ToinADMIX/ADMIXData/2023-2024/Posters/ADMIX_Poster_JapanOpen_2024.pdf

## 機体説明

## 回路図

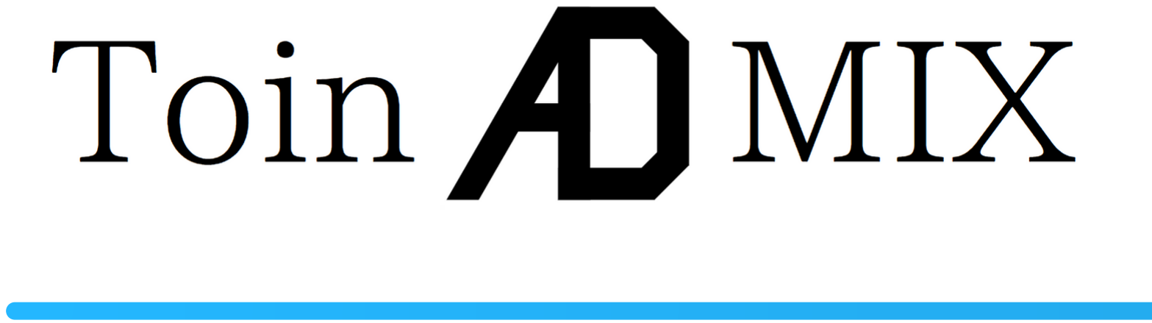
[picture p1: figure]
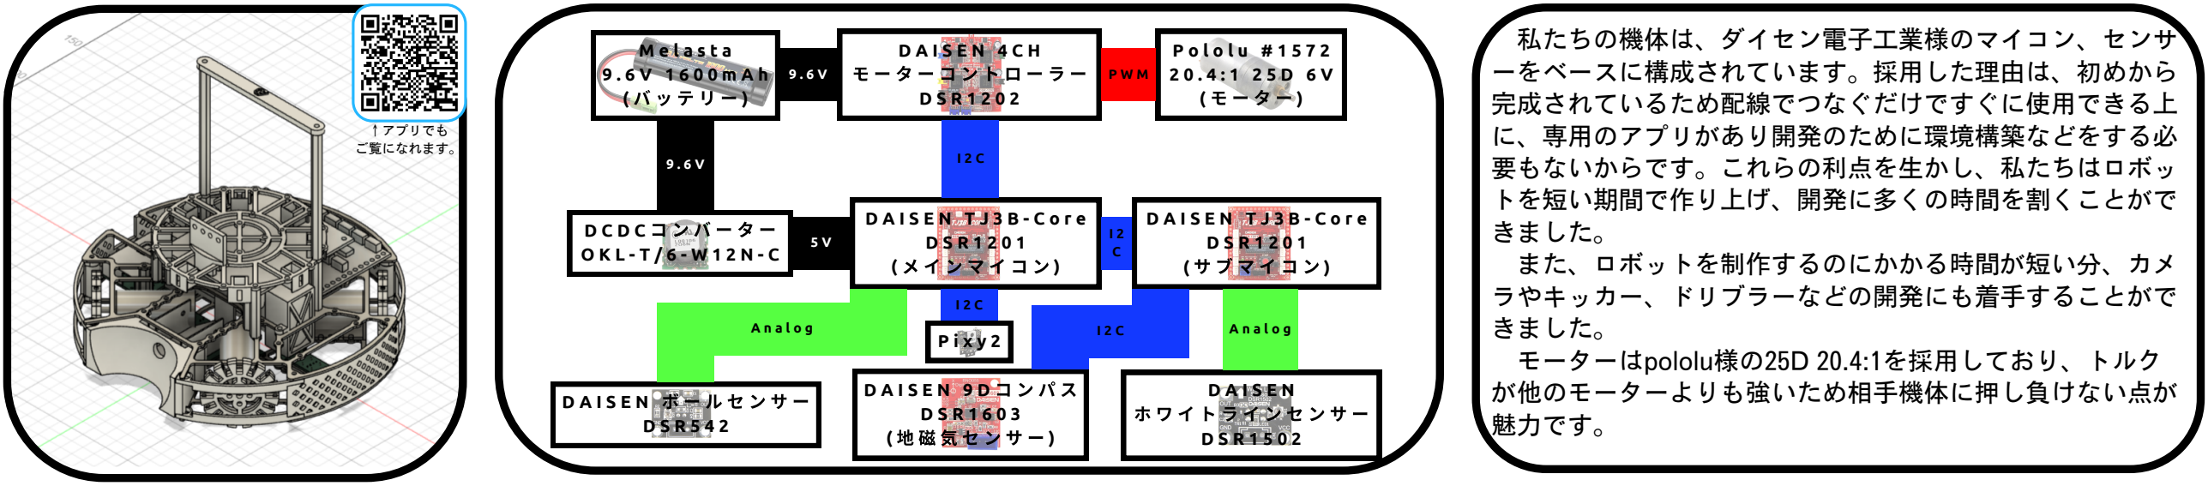
[picture p2: figure]
私たちの機体は、ダイセン電子工業様のマイコン、センサ ーをベースに構成されています。採用した理由は、初めから 完成されているため配線でつなぐだけですぐに使用できる上 に、専用のアプリがあり開発のために環境構築などをする必 要もないからです。これらの利点を生かし、私たちはロボッ トを短い期間で作り上げ、開発に多くの時間を割くことがで きました。 また、ロボットを制作するのにかかる時間が短い分、カメ ラやキッカー、ドリブラーなどの開発にも着手することがで きました。 モーターはpololu様の25D 20.4:1を採用しており、トルク が他のモーターよりも強いため相手機体に押し負けない点が 魅力です。; ↑アプリでも ご覧になれます。

## Pixyカメラを用いたシュート

## 合理的なライン処理

HomePage | Blog | X

### Asahi Ueno Haruku Akema Hiromiti Matsui

和歌山県立桐蔭高等学校科学部
和歌山ノード3位
関西ブロック3位
安定した防御 | アプリの活用

## 3Dモデル

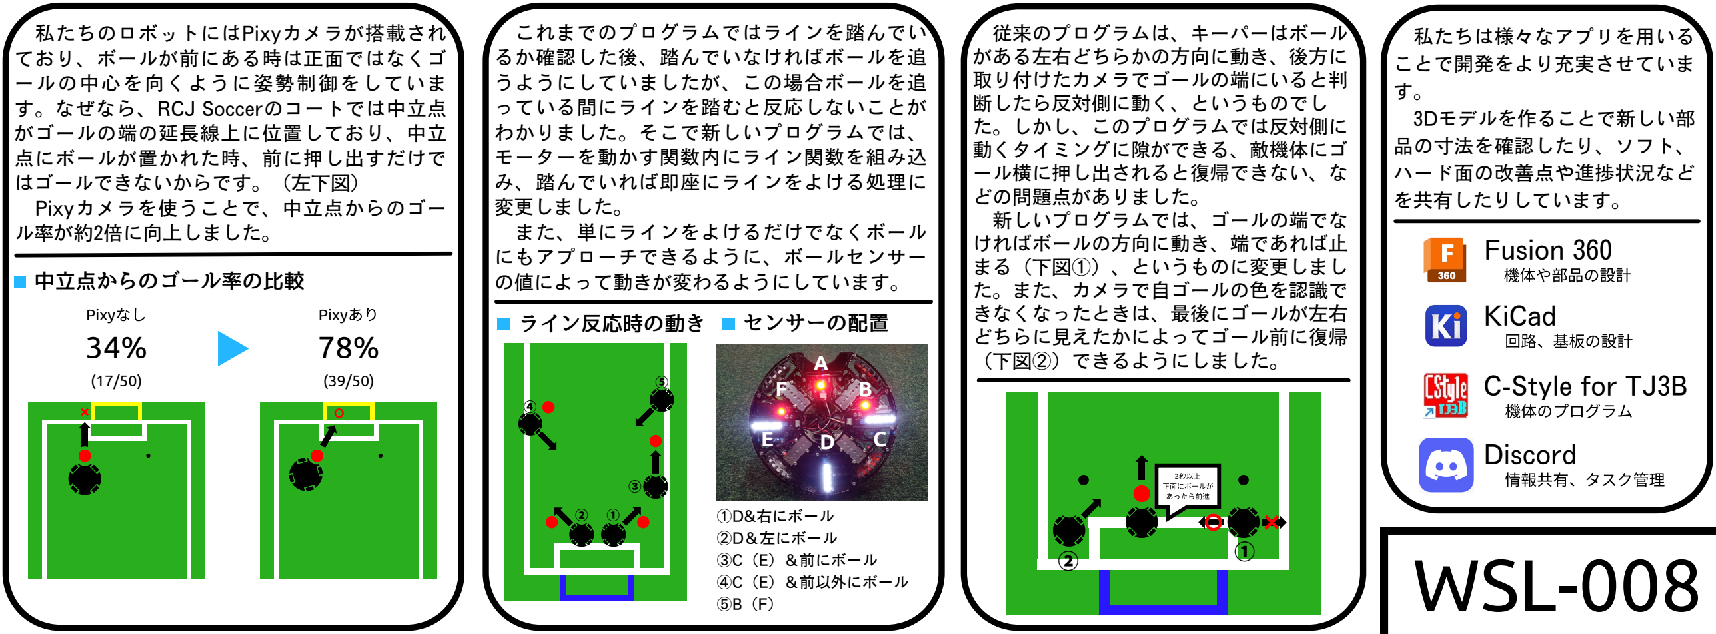
[picture p3: figure]
中立点からのゴール率の比較; Pixyなし; Pixyあり; 私たちのロボットにはPixyカメラが搭載され ており、ボールが前にある時は正面ではなくゴ ールの中心を向くように姿勢制御をしていま す。なぜなら、RCJ Soccerのコートでは中立点 がゴールの端の延長線上に位置しており、中立 点にボールが置かれた時、前に押し出すだけで はゴールできないからです。（左下図） Pixyカメラを使うことで、中立点からのゴー ル率が約2倍に向上しました。; ライン反応時の動き; センサーの配置; ①D&右にボール ②D＆左にボール ③C（E）＆前にボール ④C（E）＆前以外にボール ⑤B（F）; これまでのプログラムではラインを踏んでい るか確認した後、踏んでいなければボールを追 うようにしていましたが、この場合ボールを追 っている間にラインを踏むと反応しないことが わかりました。そこで新しいプログラムでは、 モーターを動かす関数内にライン関数を組み込 み、踏んでいれば即座にラインをよける処理に 変更しました。 また、単にラインをよけるだけでなくボール にもアプローチできるように、ボールセンサー の値によって動きが変わるようにしています。; WSL-008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
