ToinADMIX/ADMIXData/2024-2025/Hard/3DModels/admix_1_dribbler_ver5.step

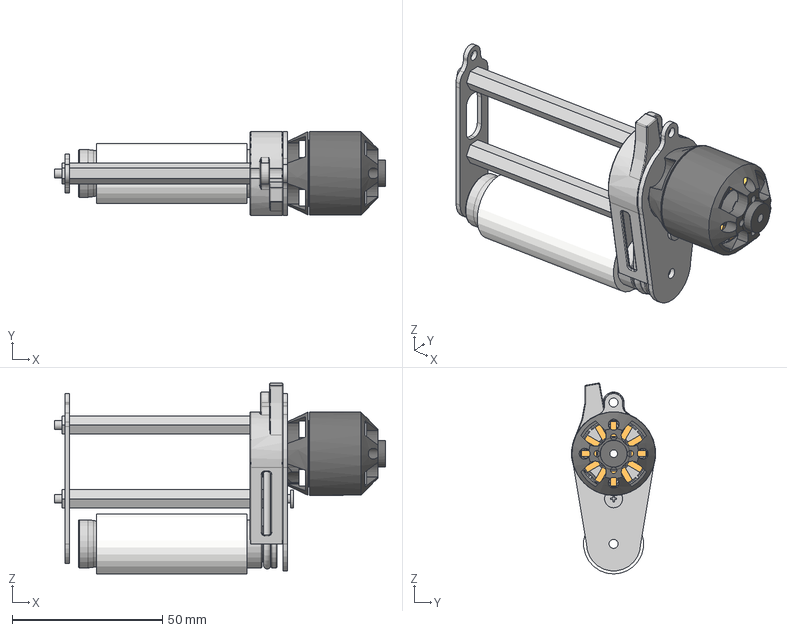
[picture p4: CAD file, 2025-06-26]
2024-2025/Hard/3DModels/admix_1_dribbler_ver5.step
110.1 x 27.9 x 63.5 mm
coil
dribbler5_alumiR
dribbler4_pillar
dribbler3_tube
dribbler5_rubberwheel
dribbler5_wheel_motor
spacer_10mm
spacer_60mm x 2
nut x 2
flatscrew x 2
dribbler5_alumiL_ver2
dribbler5_cover_ver2
