ToinADMIX/ADMIXData/2024-2025/Posters/ADMIX_Poster_JapanOpen_2025.pdf

## 回路図

## 上野朝陽 - 設計

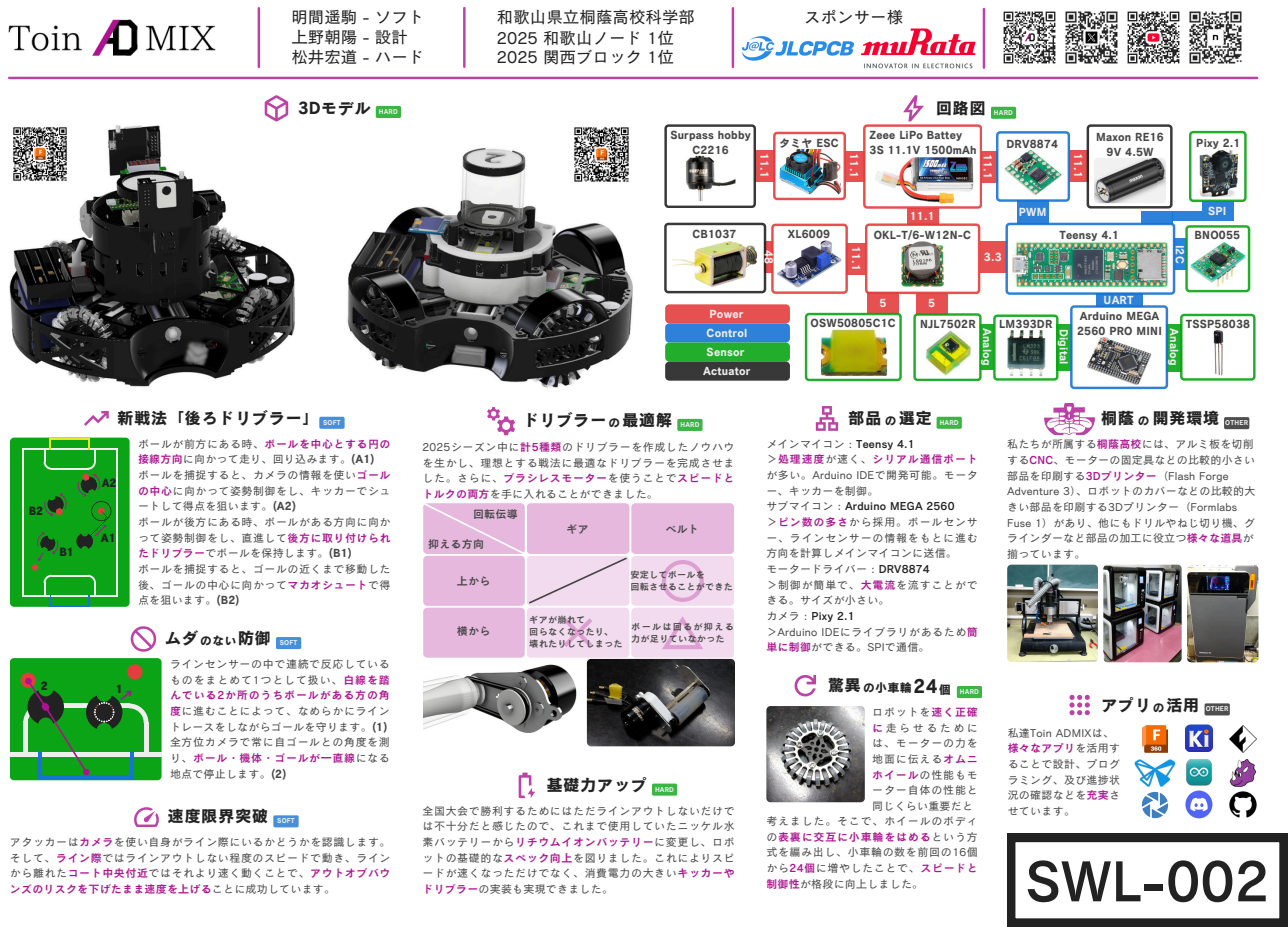
[picture p5: page 1]
SWL-002; 新戦法「後ろドリブラー」; ボールが前方にある時、ボールを中心とする円の 接線方向に向かって走り、回り込みます。(A1) ボールを捕捉すると、カメラの情報を使いゴール の中心に向かって姿勢制御をし、キッカーでシュ ートして得点を狙います。(A2) ボールが後方にある時、ボールがある方向に向か って姿勢制御をし、直進して後方に取り付けられ たドリブラーでボールを保持します。(B1) ボールを捕捉すると、ゴールの近くまで移動した 後、ゴールの中心に向かってマカオシュートで得 点を狙います。(B2); SOFT; ラインセンサーの中で連続で反応している ものをまとめて1つとして扱い、白線を踏 んでいる2か所のうちボールがある方の角 度に進むことによって、なめらかにライン トレースをしながらゴールを守ります。(1) 全方位カメラで常に自ゴールとの角度を測 り、ボール・機体・ゴールが一直線になる 地点で停止します。(2); ムダのない防御 SOFT; 速度限界突破; 抑える方向; 上から; 回転伝導; 横から; ベルト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

Zeee LiPo Battey
3S 11.1V 1500mAh

部品の 選定 HARD

桐蔭 の 開発環境 OTHER

2025シーズン中に計5種類のドリブラーを作成したノウハウ
を生かし、理想とする戦法に最適なドリブラーを完成させま
した。さらに、ブラシレスモーターを使うことでスピードと
トルクの両方を手に入れることができました。

メインマイコン : Teensy 4.1
＞処理速度が速く、シリアル通信ポート
が多い。Arduino IDEで開発可能。モータ
ー、キッカーを制御。
サブマイコン : Arduino MEGA 2560
＞ピン数の多さから採用。ボールセンサ
ー、ラインセンサーの情報をもとに進む
方向を計算しメインマイコンに送信。
モータードライバー : DRV8874
＞制御が簡単で、大電流を流すことがで
きる。サイズが小さい。
カメラ : Pixy 2.1
＞Arduino IDEにライブラリがあるため簡
単に制御ができる。SPIで通信。

私たちが所属する桐蔭高校には、アルミ板を切削
するCNC、モーターの固定具などの比較的小さい
部品を印刷する3Dプリンター（Flash Forge
Adventure 3）、ロボットのカバーなどの比較的大
きい部品を印刷する3Dプリンター（Formlabs
Fuse 1）があり、他にもドリルやねじ切り機、グ
ラインダーなど部品の加工に役立つ様々な道具が
揃っています。

アタッカーはカメラを使い自身がライン際にいるかどうかを認識します。
そして、ライン際ではラインアウトしない程度のスピードで動き、ライン
から離れたコート中央付近ではそれより速く動くことで、アウトオブバウ
ンズのリスクを下げたまま速度を上げることに成功しています。
