ToinADMIX/ADMIXData/2024-2025/Posters/ADMIX_Poster_KansaiBlock_2025.pdf

## 3Dモデル

# カメラを用いたシュート

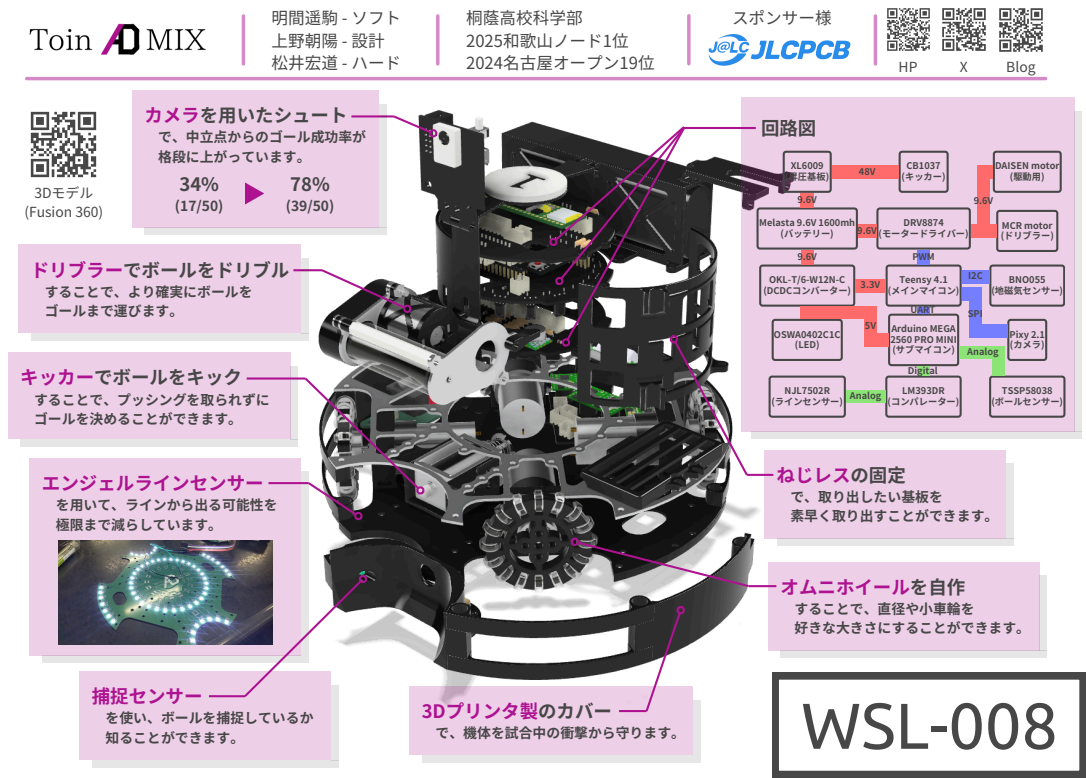
[picture p6: page 1]
エンジェルラインセンサー を用いて、ラインから出る可能性を 極限まで減らしています。; ねじレスの固定 で、取り出したい基板を 素早く取り出すことができます。; 捕捉センサー を使い、ボールを捕捉しているか 知ることができます。; キッカーでボールをキック することで、プッシングを取られずに ゴールを決めることができます。; 3Dプリンタ製のカバー で、機体を試合中の衝撃から守ります。; ドリブラーでボールをドリブル することで、より確実にボールを ゴールまで運びます。; オムニホイールを自作 することで、直径や小車輪を 好きな大きさにすることができます。 WSL-008; (Fusion 360); で、中立点からのゴール成功率が 格段に上がっています。 34% (17/50); Melasta 9.6V 1600mh (バッテリー); OKL-T/6-W12N-C (DCDCコンバーター); Teensy 4.1 (メインマイコン); Pixy 2.1 (カメラ); Arduino MEGA 2560 PRO MINI (サブマイコン); LM393DR (コンパレーター)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
