ToinADMIX/ADMIXData/2024-2025/Hard/Circuits/1/HoldSensor_2.pdf

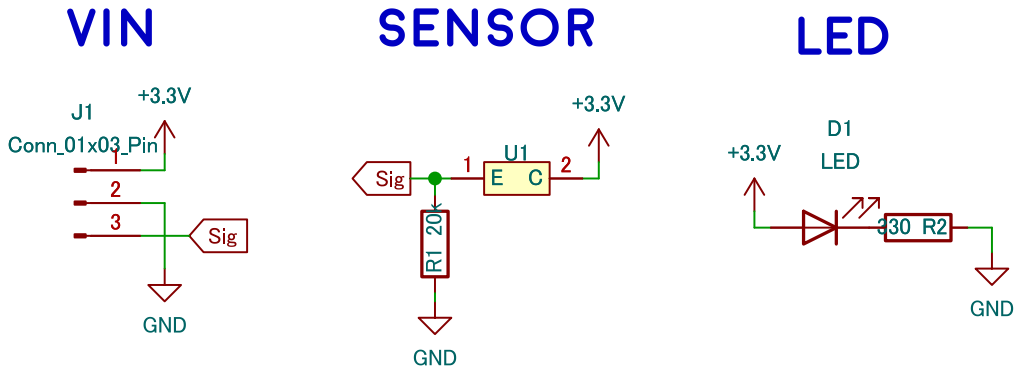
[picture p7: page 1]

Id: 1/1 Title: File:HoldSensor_2.kicad_sch Sheet:/
