ToinADMIX/ADMIXData/2024-2025/Hard/Circuits/1/Kicker_1_ver2.pdf

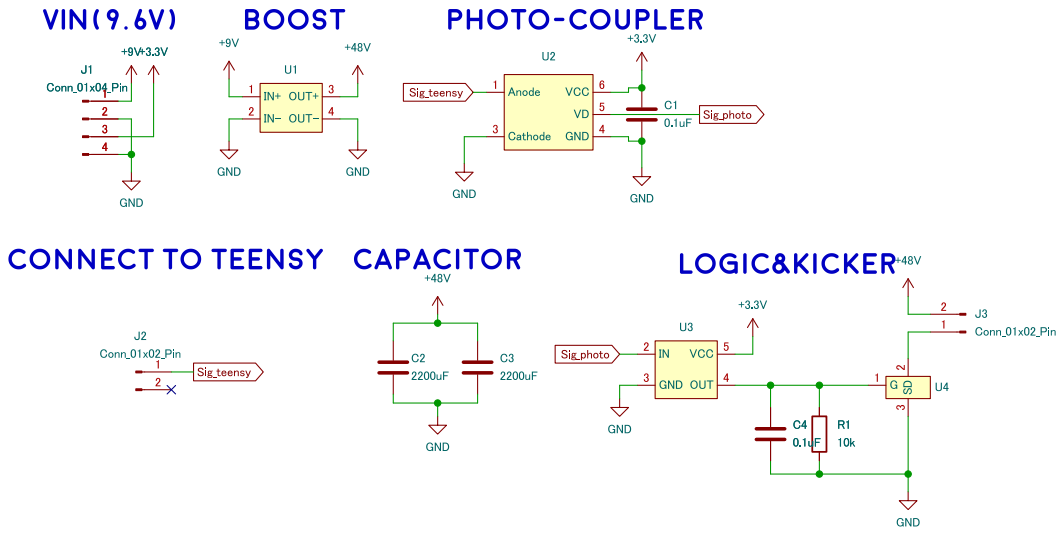
[picture p8: page 1]

Id: 1/1 Title: File:Kicker_1_ver2.kicad_sch Sheet:/
