ToinADMIX/ADMIXData/2024-2025/Hard/Circuits/1/Main.pdf

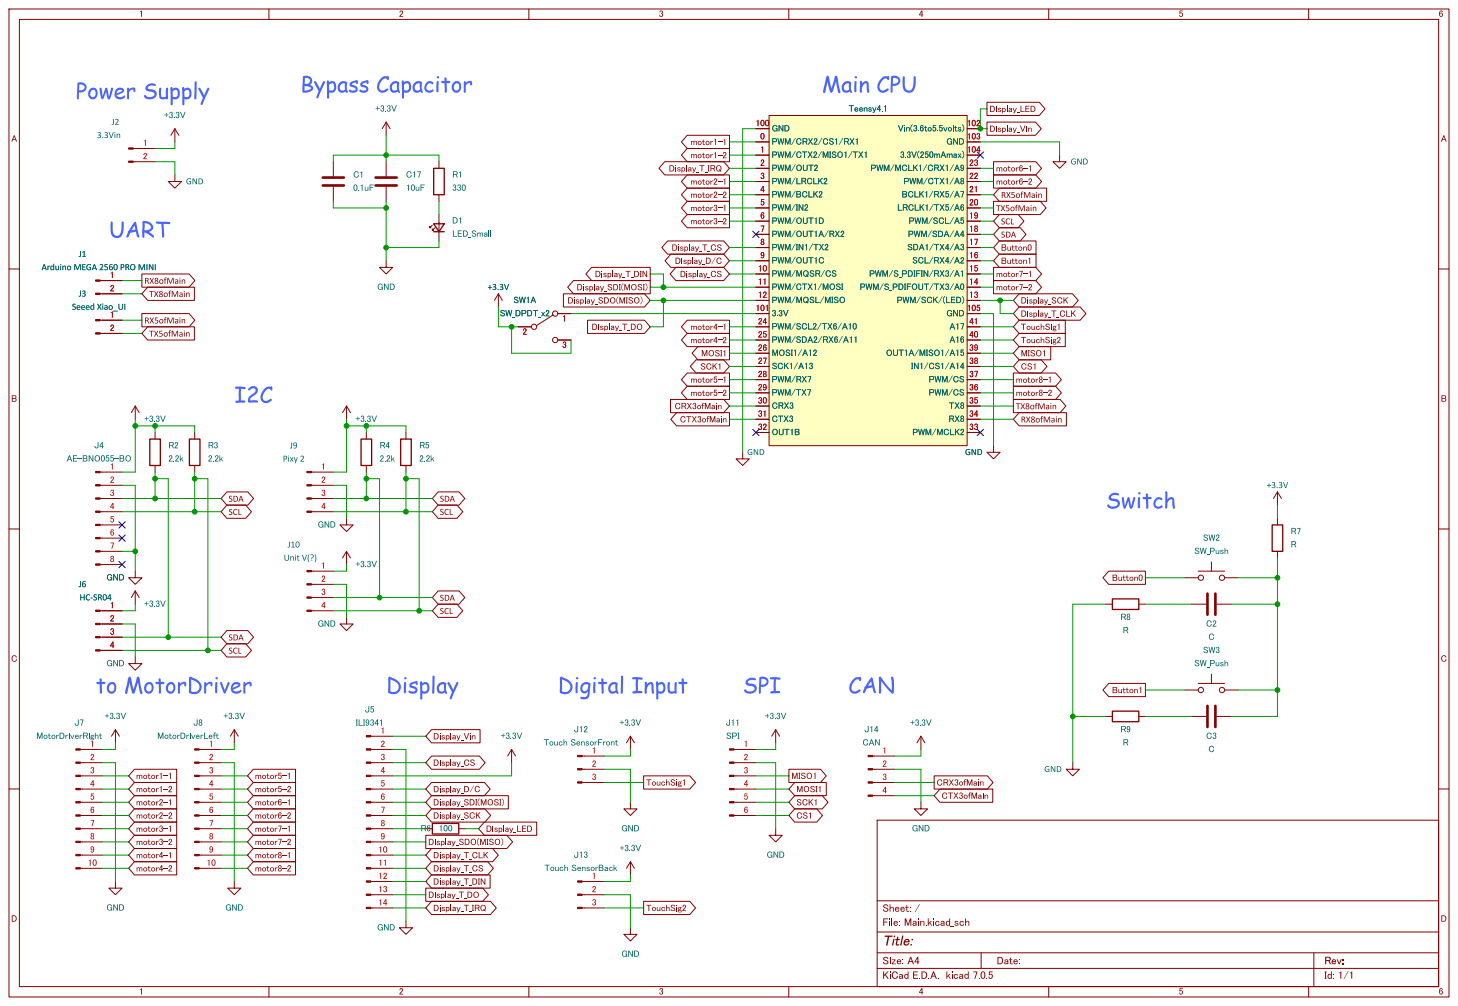
[picture p9: page 1]

Id: 1/1 Title: File:Main.kicad_sch Sheet:/ +3.3V
