ToinADMIX/ADMIXData/2024-2025/Hard/Circuits/1/MD_1_ver2.pdf

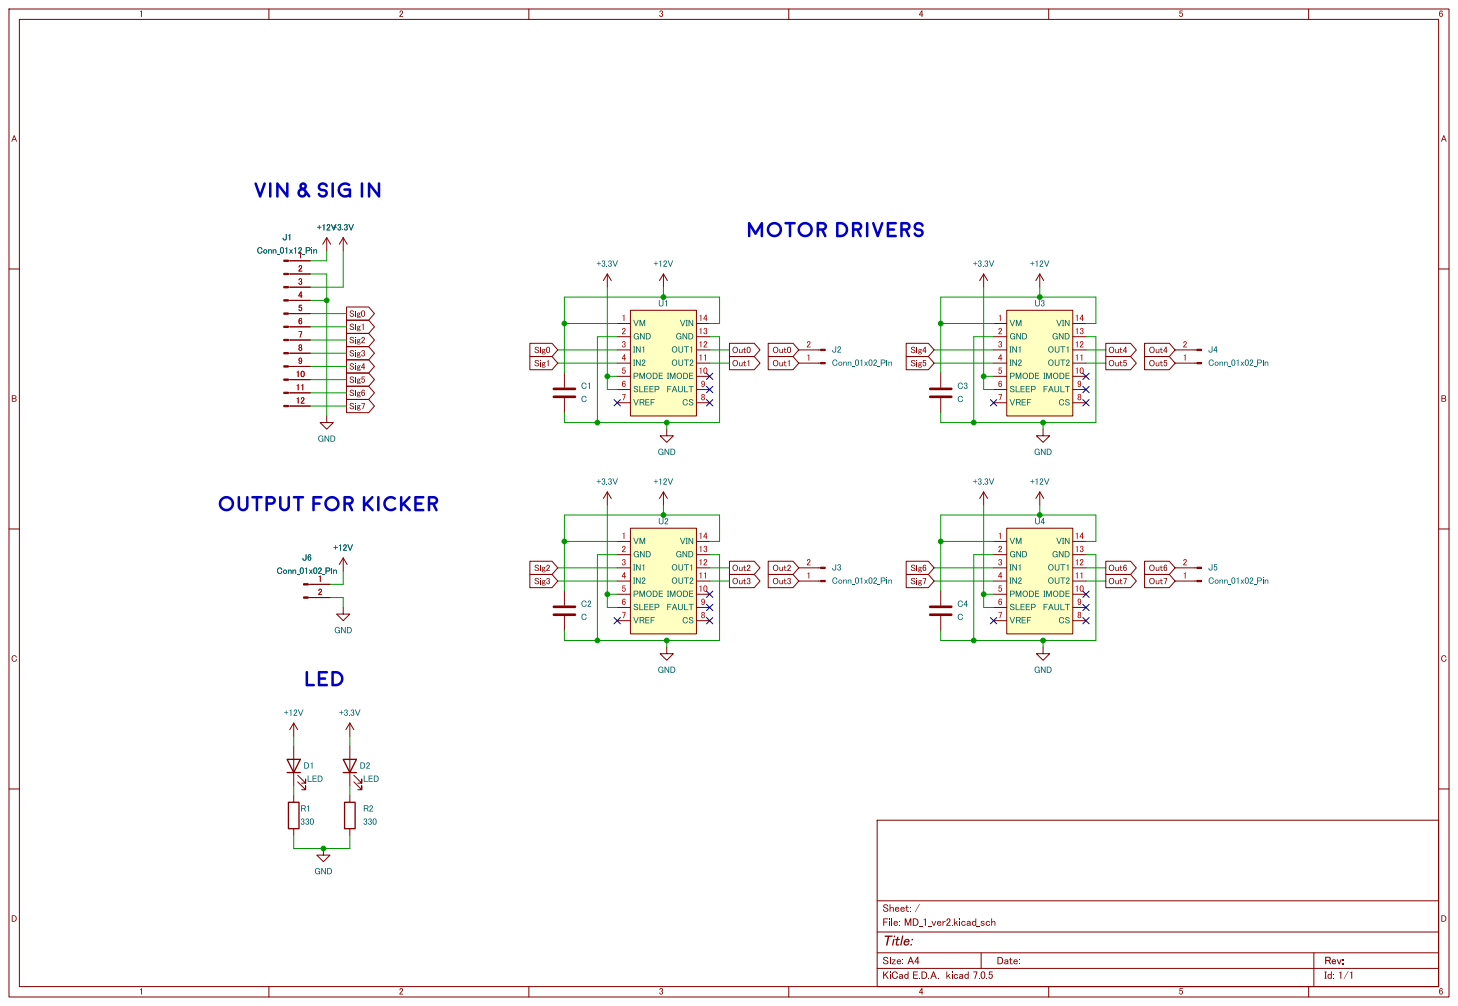
[picture p10: page 1]

Id: 1/1 Title: File:MD_1_ver2.kicad_sch Sheet:/
