ToinADMIX/ADMIXData/2024-2025/Hard/Circuits/1/PowerSupply_1.pdf

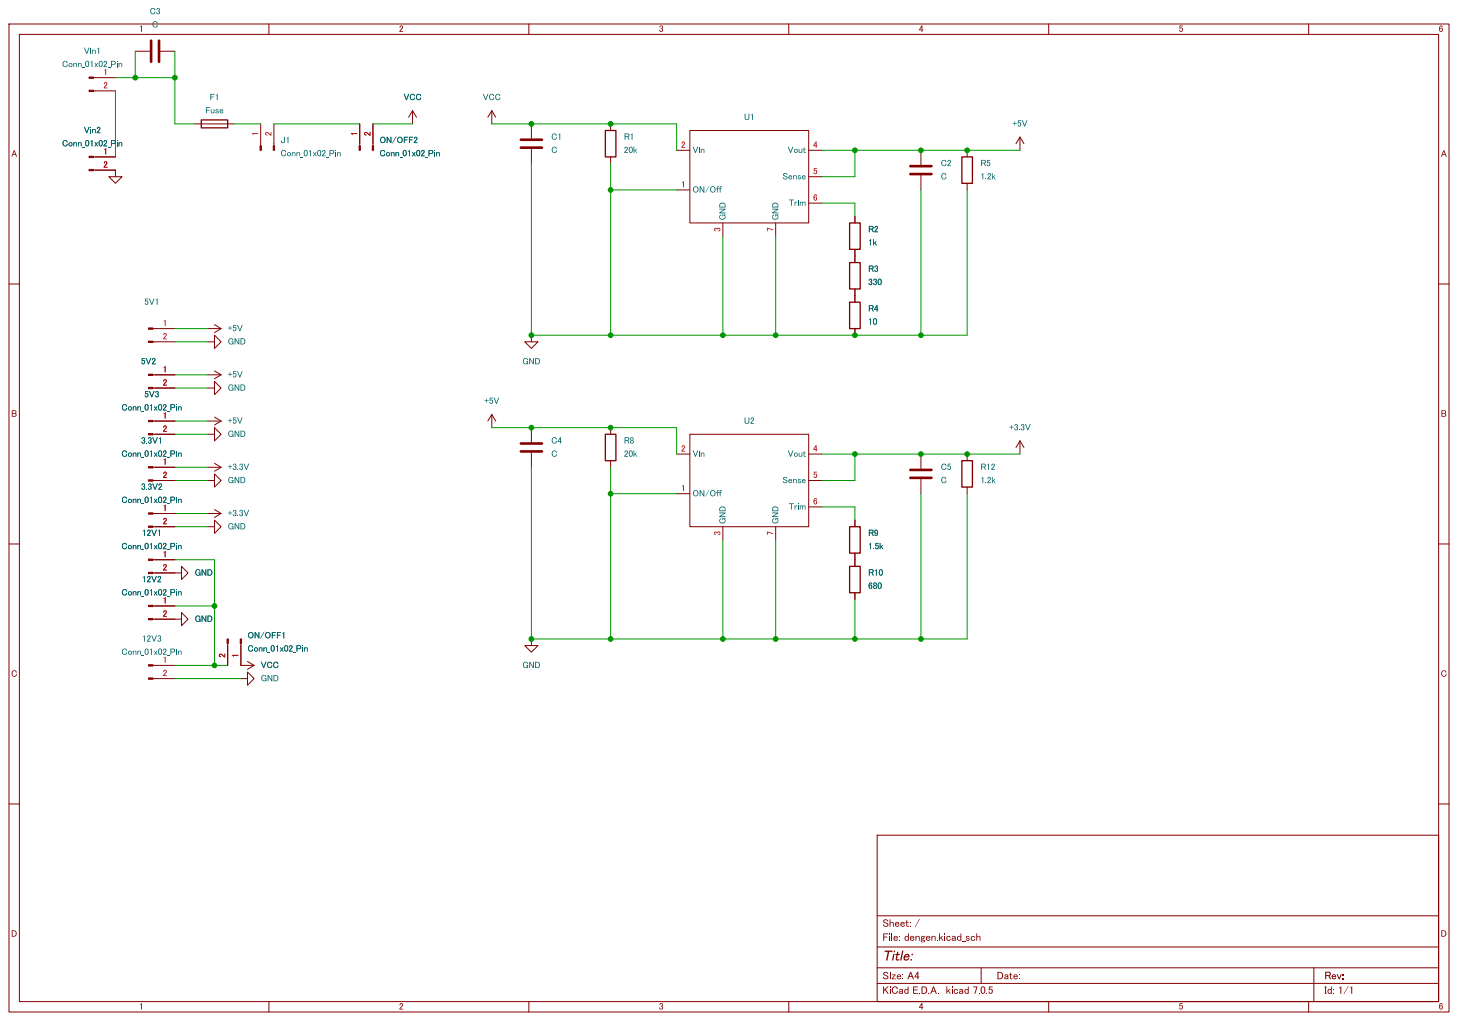
[picture p11: page 1]

Id: 1/1 Title: File:dengen.kicad_sch Sheet:/ GND GND
