ToinADMIX/ADMIXData/2024-2025/Hard/Circuits/1/Protection_1&2.pdf

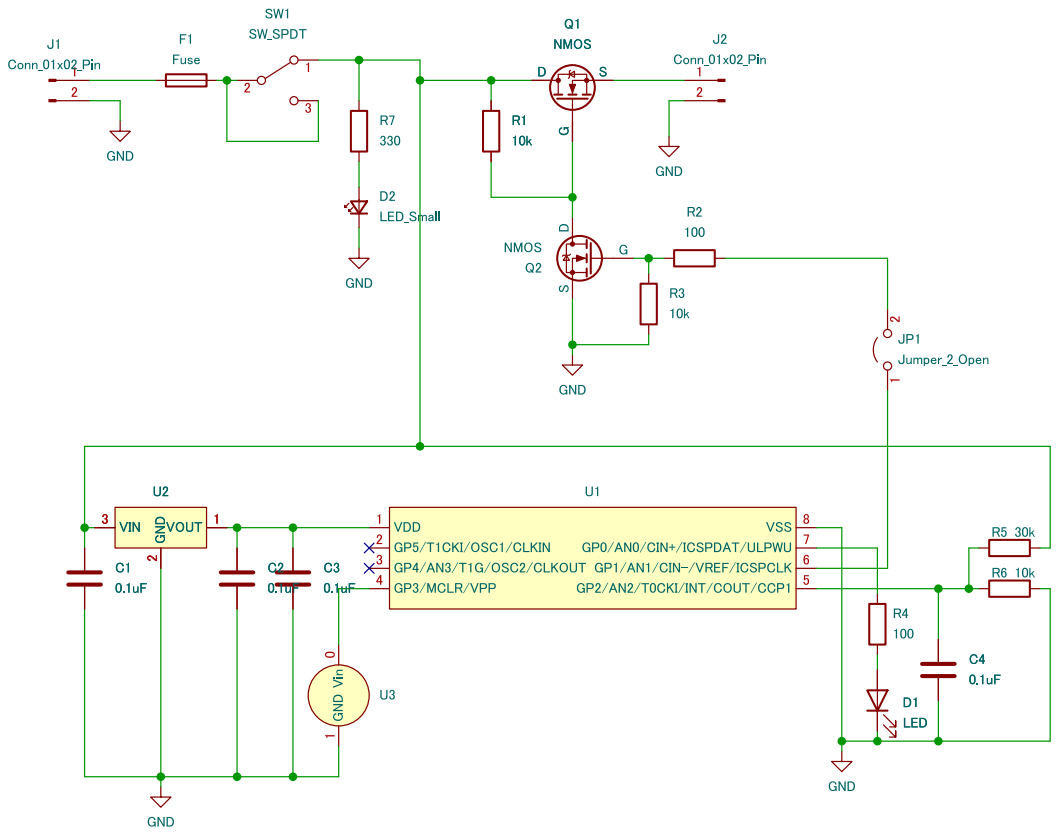
[picture p12: page 1]

Id: 1/1 Title: File:Protection_1&2.kicad_sch Sheet:/ GND
