ToinADMIX/ADMIXData/2024-2025/Hard/Circuits/1/Switch_1_ver2.pdf

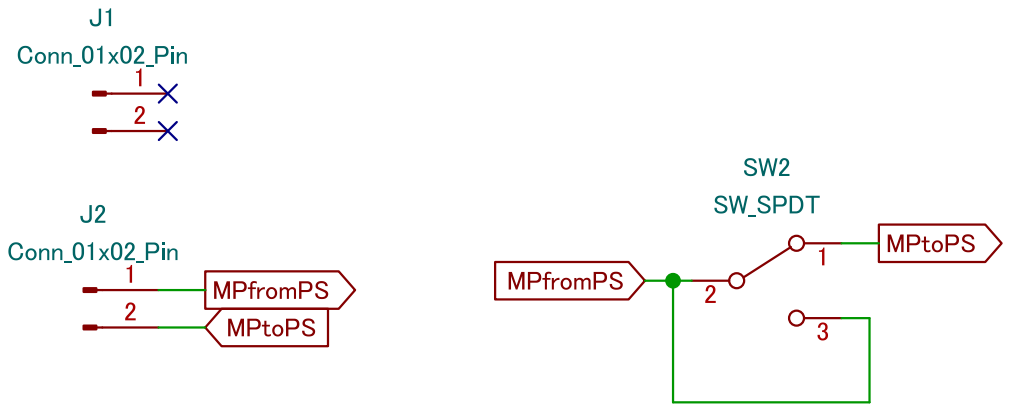
[picture p13: page 1]

Id: 1/1 Title: File:Switch_1_ver2.kicad_sch Sheet:/
