ToinADMIX/ADMIXData/2024-2025/Hard/Circuits/2/Main_2_ver2.pdf

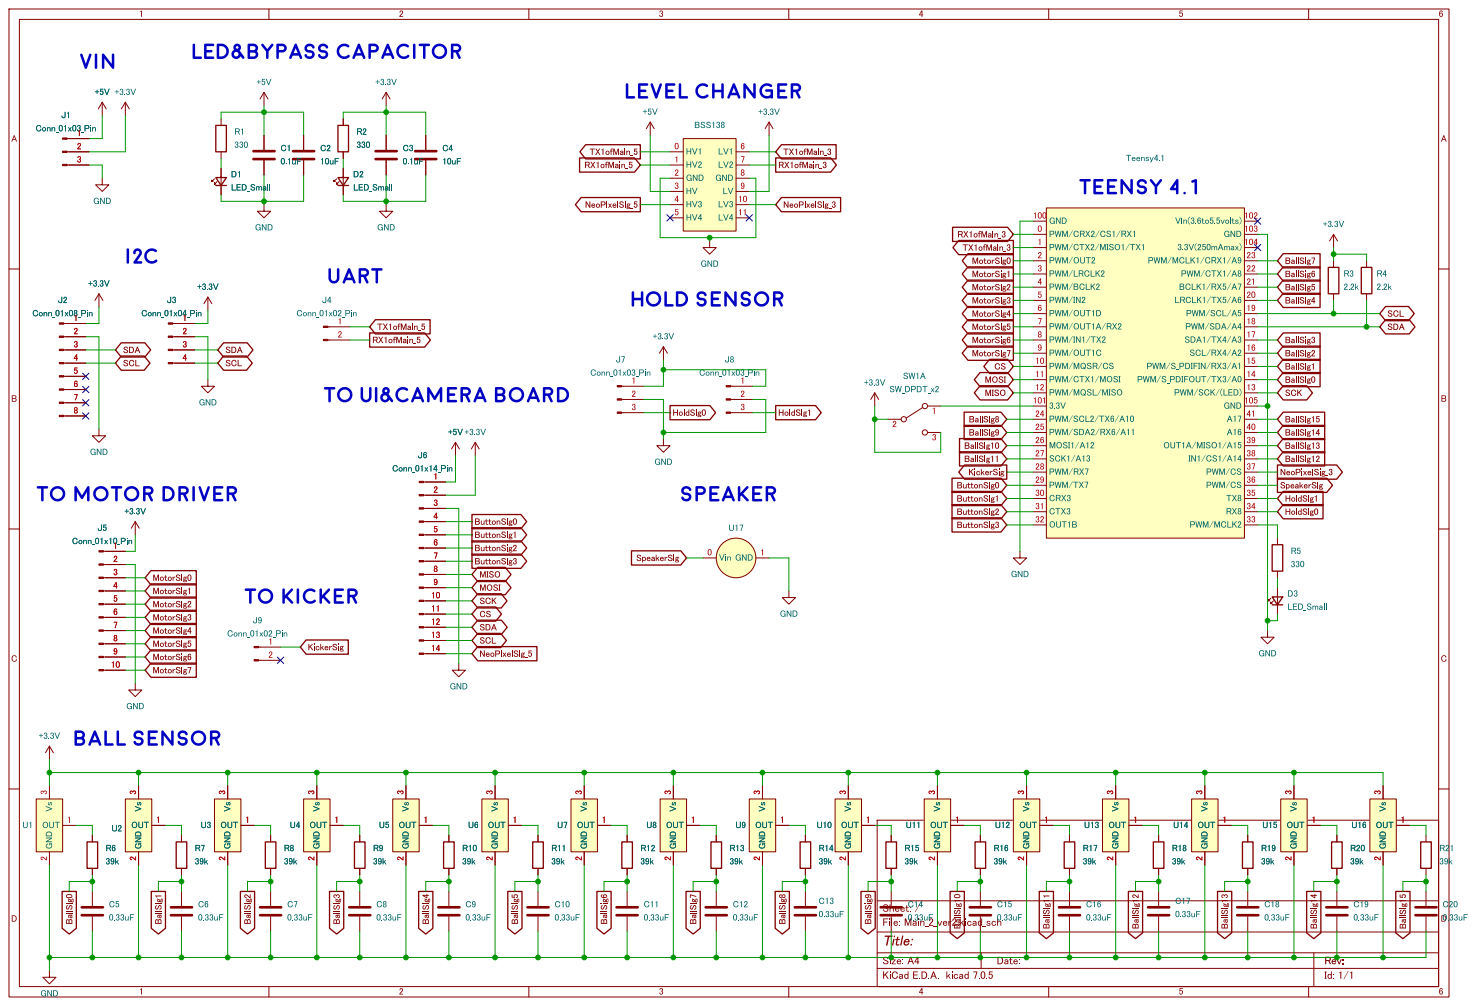
[picture p14: page 1]

to UI&camera board

Id: 1/1 Title: File:Main_2_ver2.kicad_sch Sheet:/ R14
