ToinADMIX/ADMIXData/2024-2025/Hard/Circuits/2/PowerSupply_2.pdf

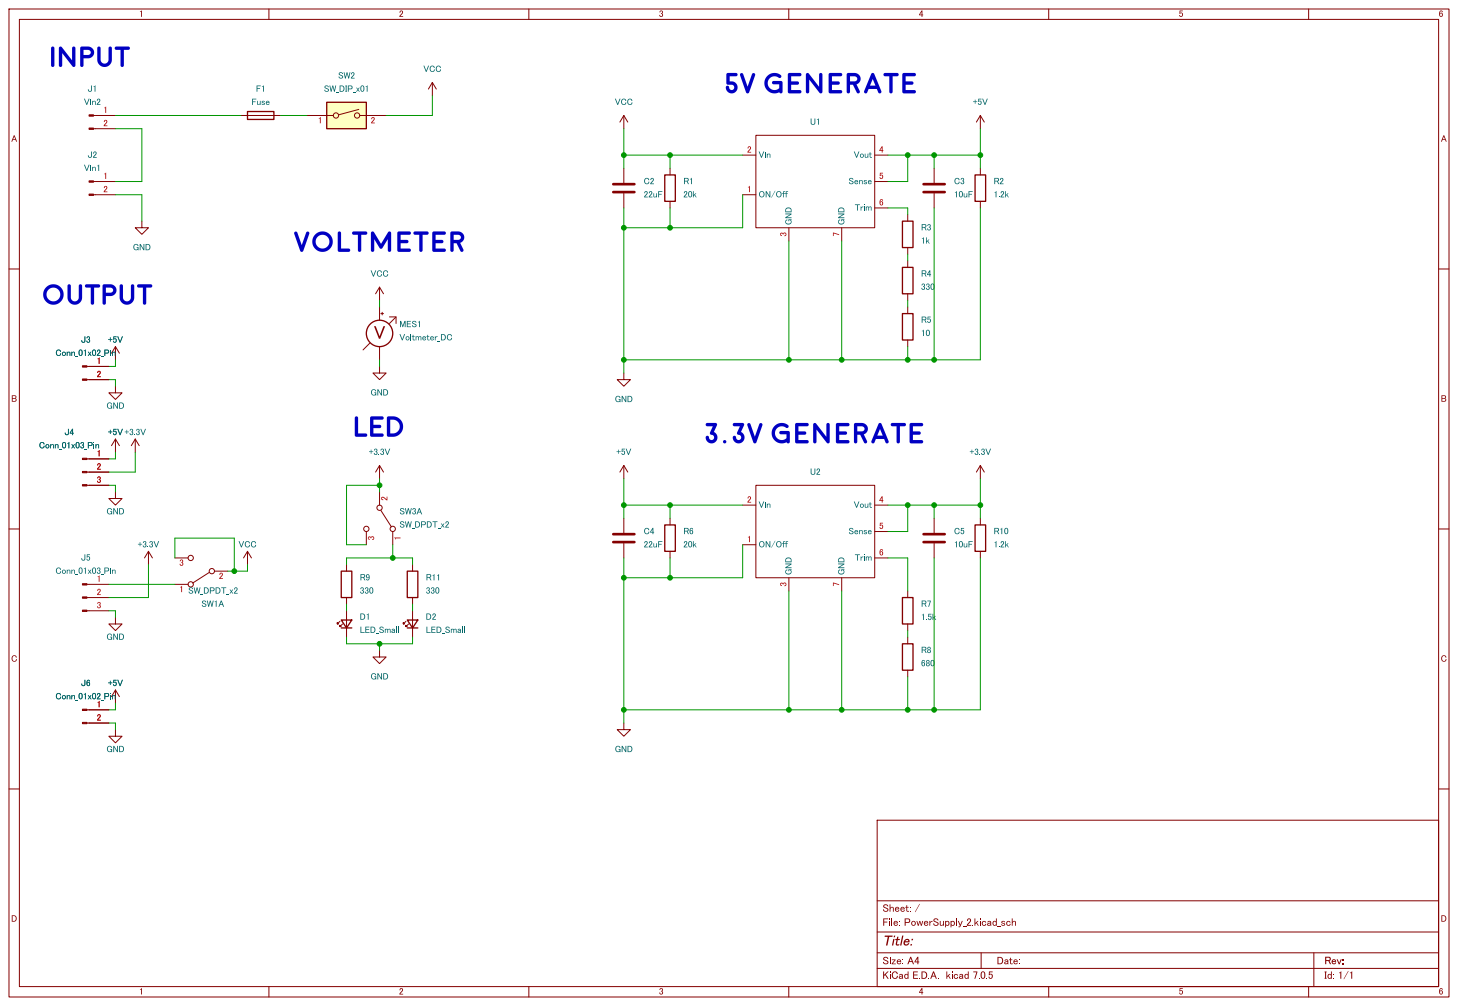
[picture p15: page 1]

Id: 1/1 Title: File:PowerSupply_2.kicad_sch Sheet:/
