ToinADMIX/ADMIXData/2024-2025/Hard/Circuits/2/UI&Camera_2.pdf

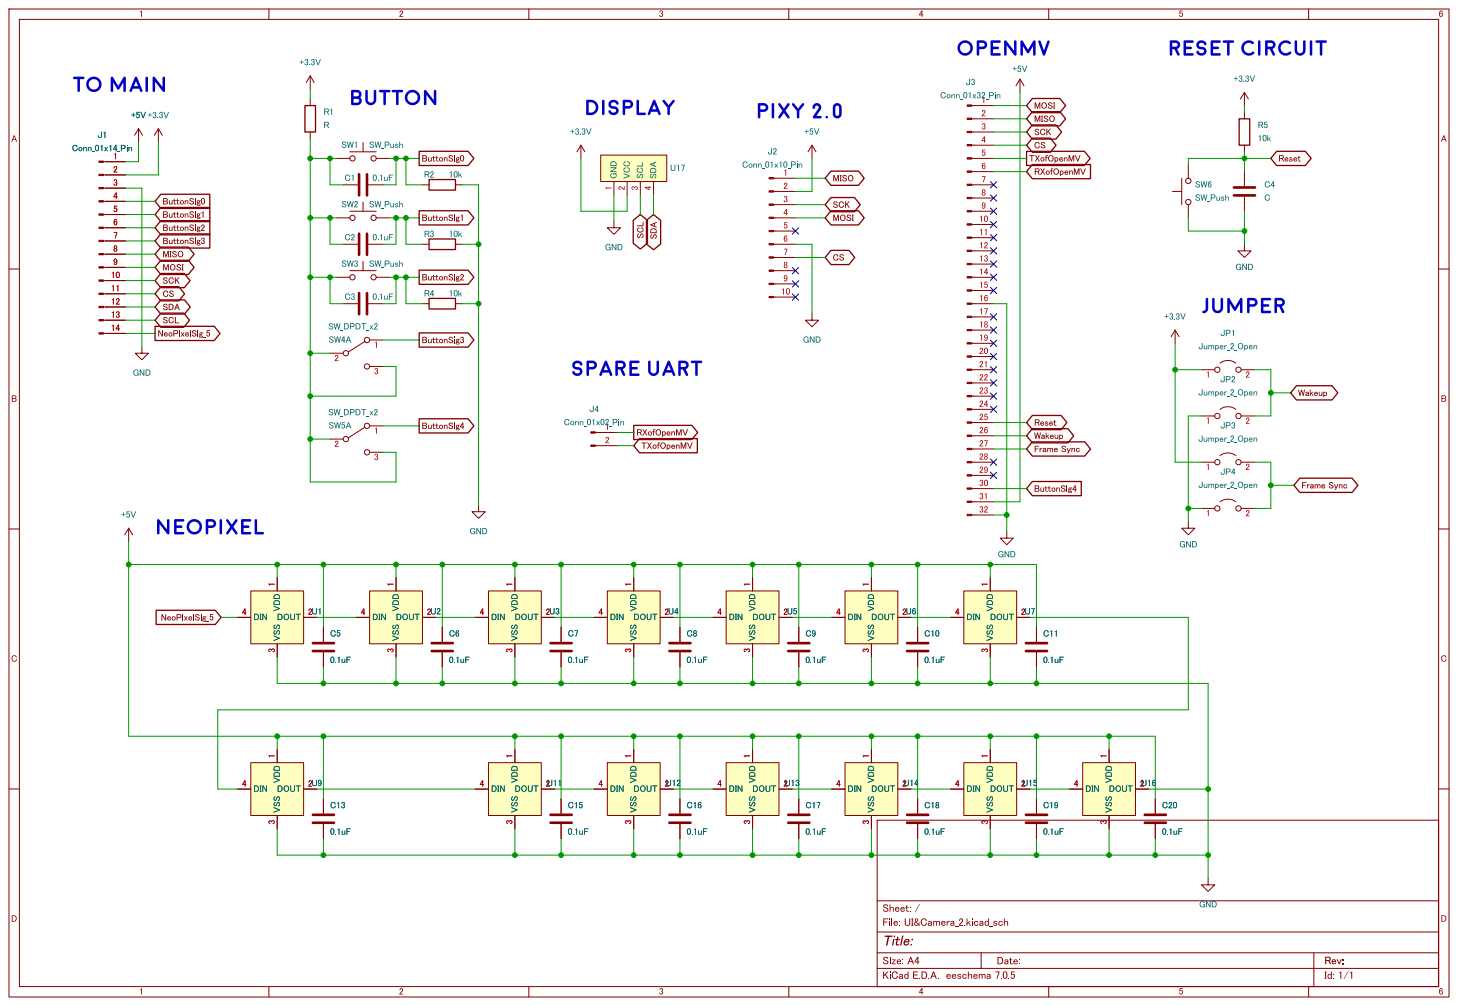
[picture p16: page 1]

Id: 1/1 Title: File:UI&Camera_2.kicad_sch Sheet:/
